roman-de-santos/E155Project/Quarto/team.qmd

---
title: "Team"
format: html
css-styles: |
  .team-member {
    text-align: center;
  }
  .team-member img {
    border-radius: 50%;
    width: 150px;
    height: 150px;
    object-fit: cover;
    margin-bottom: 1rem;
  }
  /* Button Styling */
  .linkedin-btn {
    display: inline-block;
    background-color: #0077b5; /* LinkedIn Blue */
    color: white;
    padding: 8px 16px;
    text-decoration: none;
    border-radius: 4px;
    font-size: 0.9em;
    margin-top: 10px;
    transition: background-color 0.3s;
  }
  .linkedin-btn:hover {
    background-color: #005582; /* Darker blue on hover */
    color: white;
  }
---

## Meet the Team

::: {layout-ncol=3}

::: {.team-member}


**Cameron Hernandez**

My name is Cameron Hernandez, I am a Senior at Harvey Mudd College currently perusing a bachelors in engineering. I am is passionate about electronic hardware and circuit designs. I have expierence ranging from working with power electronincs, desigining autonomous robotics, simulating electrically small antennas, and creating a multicycle processor. Stepping away from electrical engineering, I have taken engineering courses in the chemical, mechanical, material, and systems domains.

<a href="https://www.linkedin.com/in/cameron-hernandez-91b431212/" class="linkedin-btn" target="_blank">Connect on LinkedIn</a>
:::

::: {.team-member}
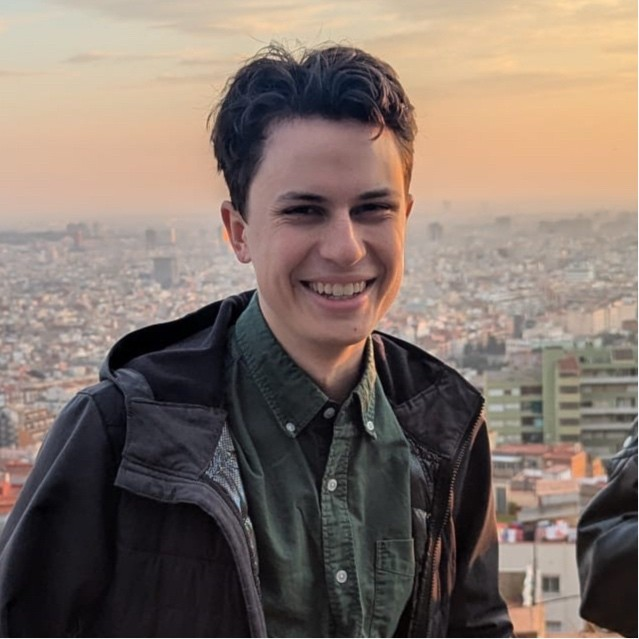
[picture p12: Quarto/images/Lucas.png]


**Lucas Lemos**

Lucas Lemos is a senior undergraduate at Harvey Mudd College studying for a B.S. Engineering. He is a self-motivated engineer & student leader passionate about merging creative design and technical expertise. He has proficiency and interest in controls and electronics. Lucas has designed an embedded audio system and PCB for Motiv Electric Trucks, an analog instrumentation PCB for the HRL Labs Clinic Team, a QTP test rack for qualifying the reactor control system PCBAs for Radiant Nuclear, and is currently developing power electronics for the Exolambda Clinic team.

<a href="https://www.linkedin.com/in/lucas-a-lemos/" class="linkedin-btn" target="_blank">Connect on LinkedIn</a>
:::

::: {.team-member}
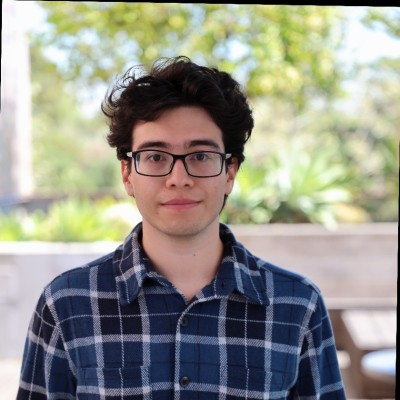
[picture p13: Quarto/images/Roman.png]


Hello, I’m Roman a student who is passionate about low-level systems. This includes C, Assembly, and IC/circuit design. I have been a TA for Computer Science, Physics, and Intro IC Lab. I am comfortable with many common Engineering software programs (Solidworks, ComSol, and Fusion) and computer languages (Matlab, Python, Java, Java Script, HTML, and C). So far, my favorite project I’ve worked on is my 32-bit CPU verification project.

**Roman De Santos**

<a href="https://www.linkedin.com/in/roman-de-santos/" class="linkedin-btn" target="_blank">Connect on LinkedIn</a>
:::

:::
