roman-de-santos/E155Project/FPGA/DSP/sim/screenshots/CDC_FTS_single.png

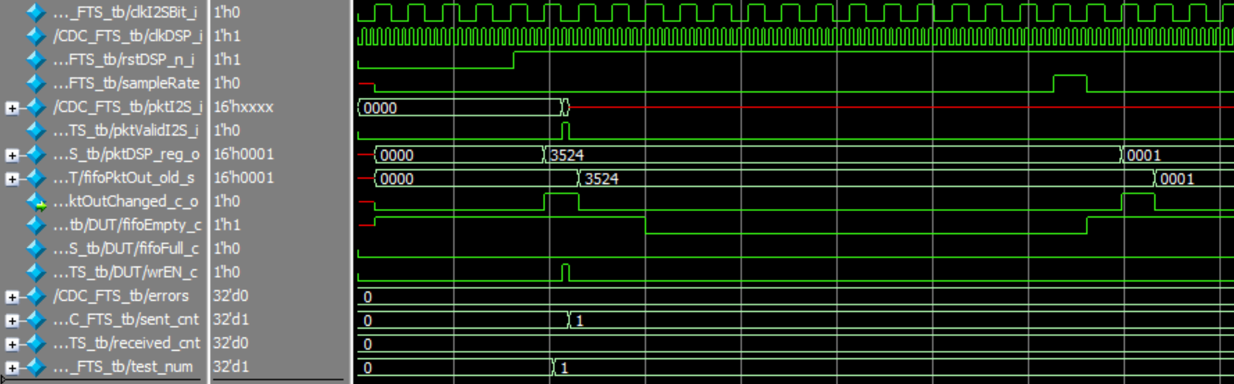
FPGA/DSP/sim/screenshots/CDC_FTS_single.png
