roman-de-santos/E155Project/FPGA/DSP/sim/screenshots/CDC_STF_multi.png

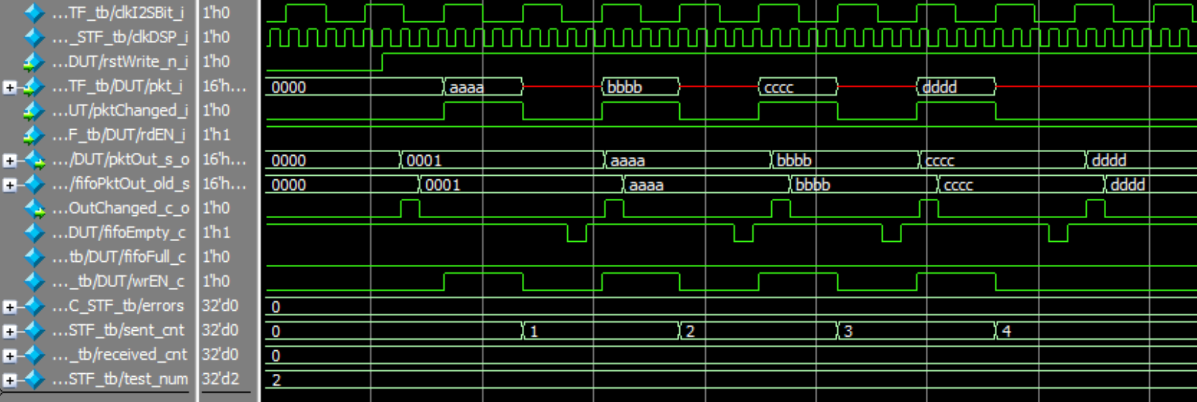
FPGA/DSP/sim/screenshots/CDC_STF_multi.png
