roman-de-santos/E155Project/FPGA/DSP/sim/screenshots/CDC_STF_single.png

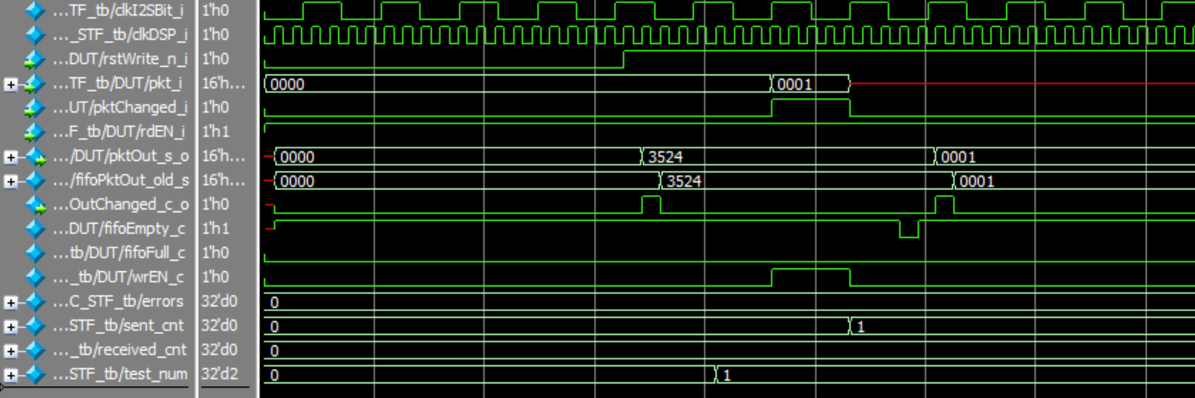
FPGA/DSP/sim/screenshots/CDC_STF_single.png
