roman-de-santos/E155Project/Gantt Chart.png

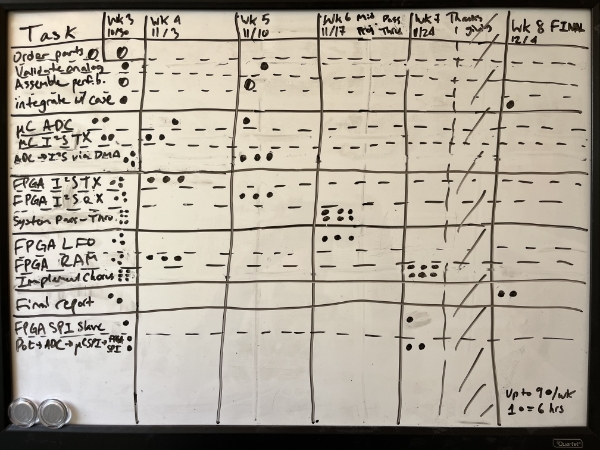
Gantt Chart.png
