roman-de-santos/E155Project/FPGA/TOP/Testbenches/screenshots/top_packet10delay10.png

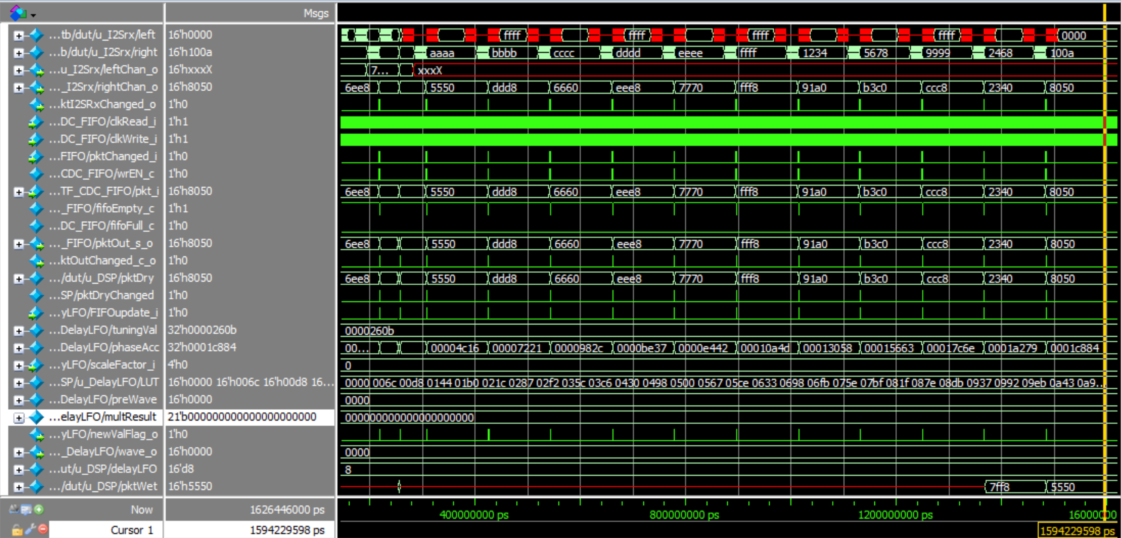
FPGA/TOP/Testbenches/screenshots/top_packet10delay10.png
