roman-de-santos/E155Project/kiCAD/tremolo_guitar_pedal/schematic3.pdf

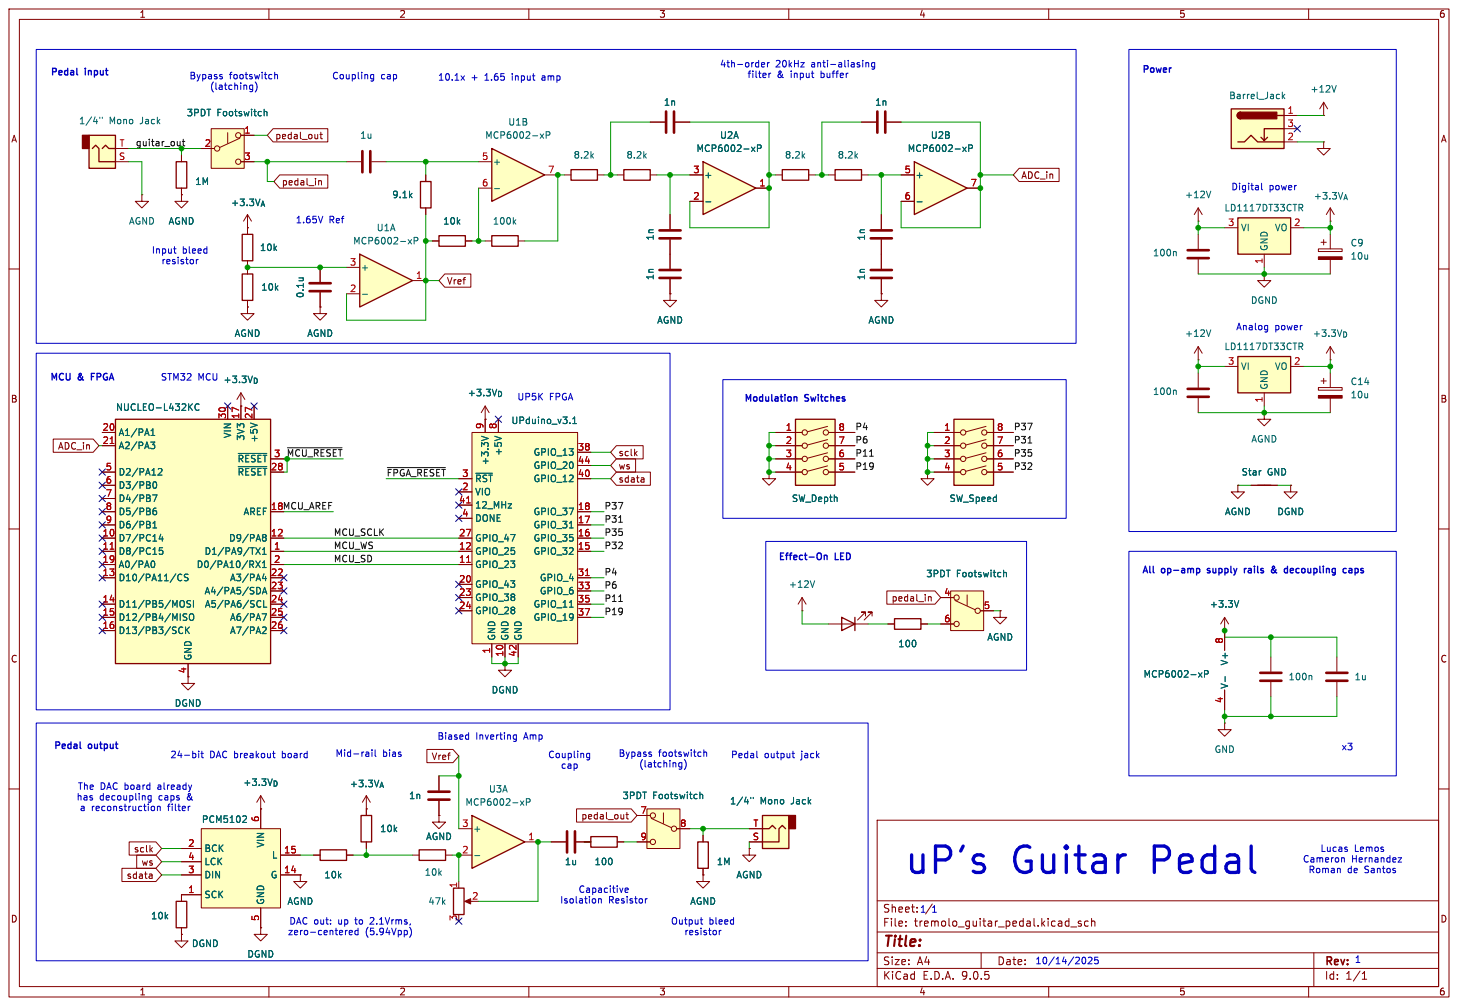
[picture p21: page 1]

14 PCM5102
Id: 1/1 Title: File: tremolo_guitar_pedal.kicad_sch Sheet: / BCK 2

Lucas Lemos Cameron Hernandez Roman de Santos
