roman-de-santos/E155Project/kiCAD/tremolo_guitar_pedal/schematic2.pdf

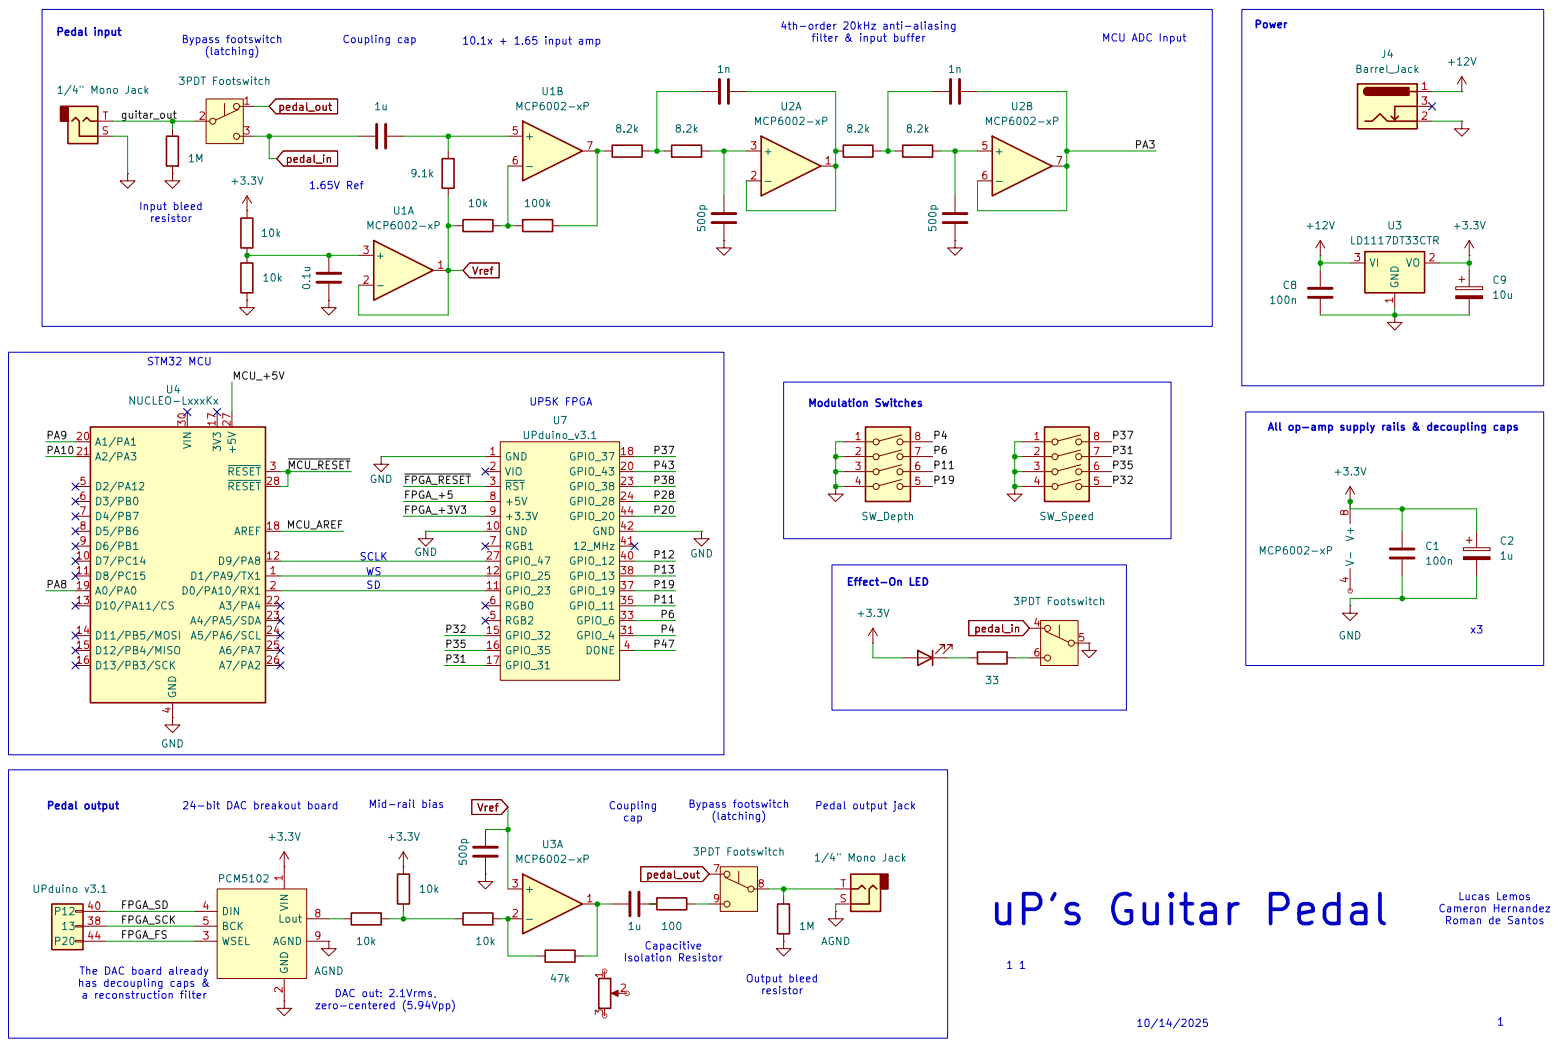
[picture p22: page 1]
