roman-de-santos/E155Project/kiCAD/tremolo_guitar_pedal/schematic1.pdf

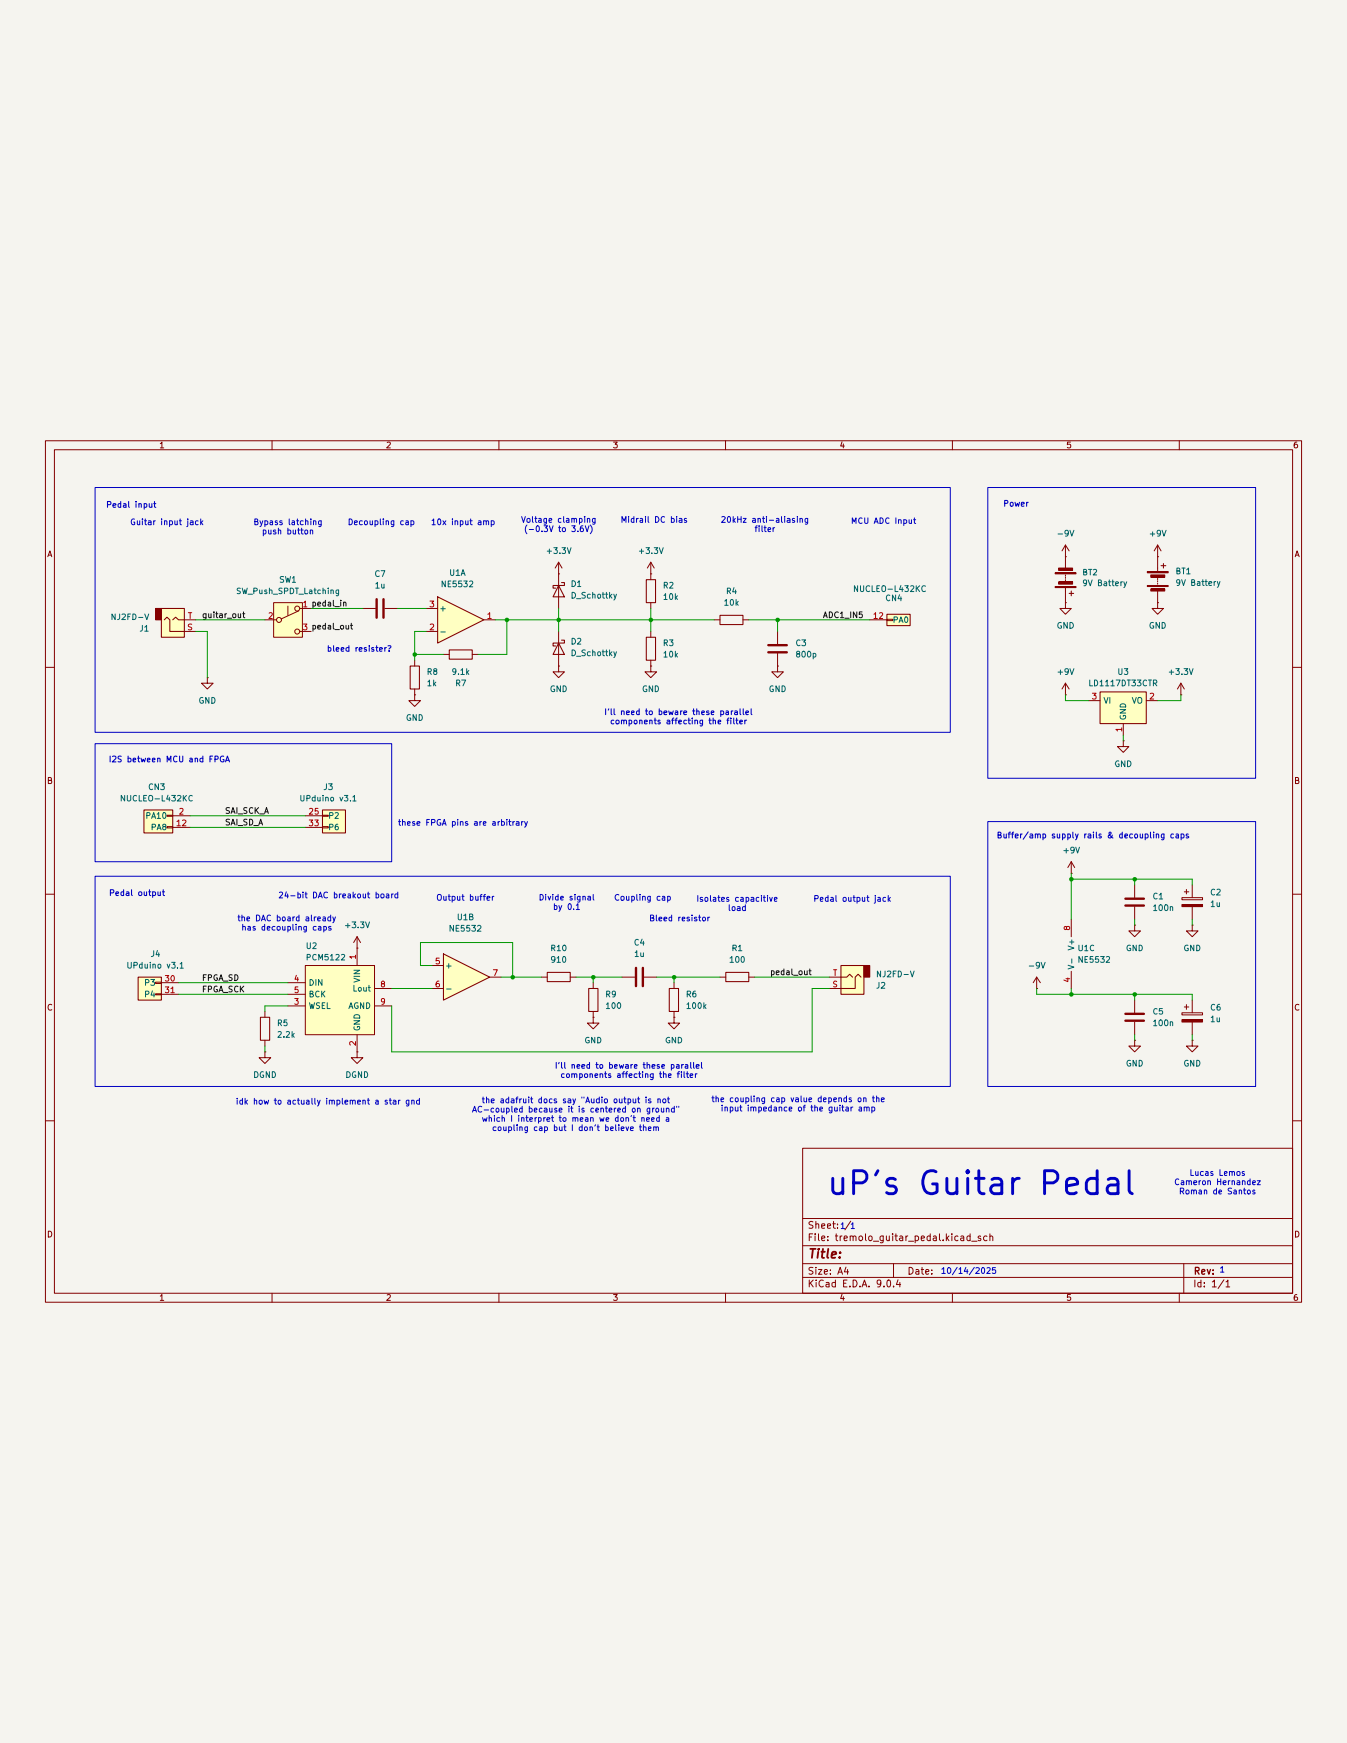
[picture p23: page 1]
