roman-de-santos/E155Project/LTspice/analog_rx.asc

C1: cap; 1n
C2: cap; 500p
C3: cap; 1n
C4: cap; 500p
C5: cap; 1µ
C6: cap; 0.1µ
C_ADC: cap; 7p
R1: res; 8.2k
R2: res; 8.2k
R3: res; 9.1k
R4: res; 10k
R5: res; 100k
R6: res; 10k
R7: res; 8.2k
R8: res; 10k
R9: res; 8.2k
R10: res; 10k
R11: res; 1Meg
R_ADC: res; 600
U1: AD8541
U2: AD8541
U7: AD8541
U8: AD8541
V1: voltage; 3.3V
V2: voltage; 9V
V6: voltage; SINE(0 300mV 80); AC 1
Named nets: 0, ADC_in, AA_out, 3V3, 9V0, AA_out2, gain_out, guitar_in, Vbias, non-inv
sallen-key 4th oorder LP AA filter
ADC sampler
.ac dec 10000 1 100k
.tran 0 100m 0 1m
simulated pickup
Biased Non-Inverting 10x Amp
w/ coupling cap
