roman-de-santos/E155Project/LTspice/analog_tx.asc

C1: cap; 0.1µ
C5: cap; 1µ
R1: res; 10k
R2: res; 10k
R3: res; 100
R4: res; 1Meg
R7: res; 10k
R8: res; 1k
U3: AD8541
V1: voltage; 3.3V
V2: voltage; 9V
V3: voltage; 1.65V
V4: voltage; SINE(0 1V 5k); AC 1
Named nets: 0, 9V0, 3V3, gain_out, dac_out, bias, coupled, out, inv, Vref
.ac dec 10000 1 100k
.tran 0 10m 0 1m
0.1x attenuation
Ref from RX chain
