roman-de-santos/E155Project/LTspice/bias_amp_rx.asc

C1: cap; 1µ
R1: res; 9.1k
R2: res; 10k
R3: res; 100k
R4: res; 10k
R5: res; 10k
R6: res; 10k
U1: AD8541
U2: AD8541
V2: voltage; 3.3
V3: voltage; SINE(0 300mV 5k); AC 1
Named nets: gain_out, 3V3, 0, guitar_in, Vbias, non-inv
.tran 0 10m 0 1m
.ac dec 10000 1 100k
