roman-de-santos/E155Project/kiCAD/tremolo_guitar_pedal/tremolo_guitar_pedal.kicad_sch

## KiCad design kiCAD/tremolo_guitar_pedal/tremolo_guitar_pedal.kicad_sch (2025-12-11, an earlier design)

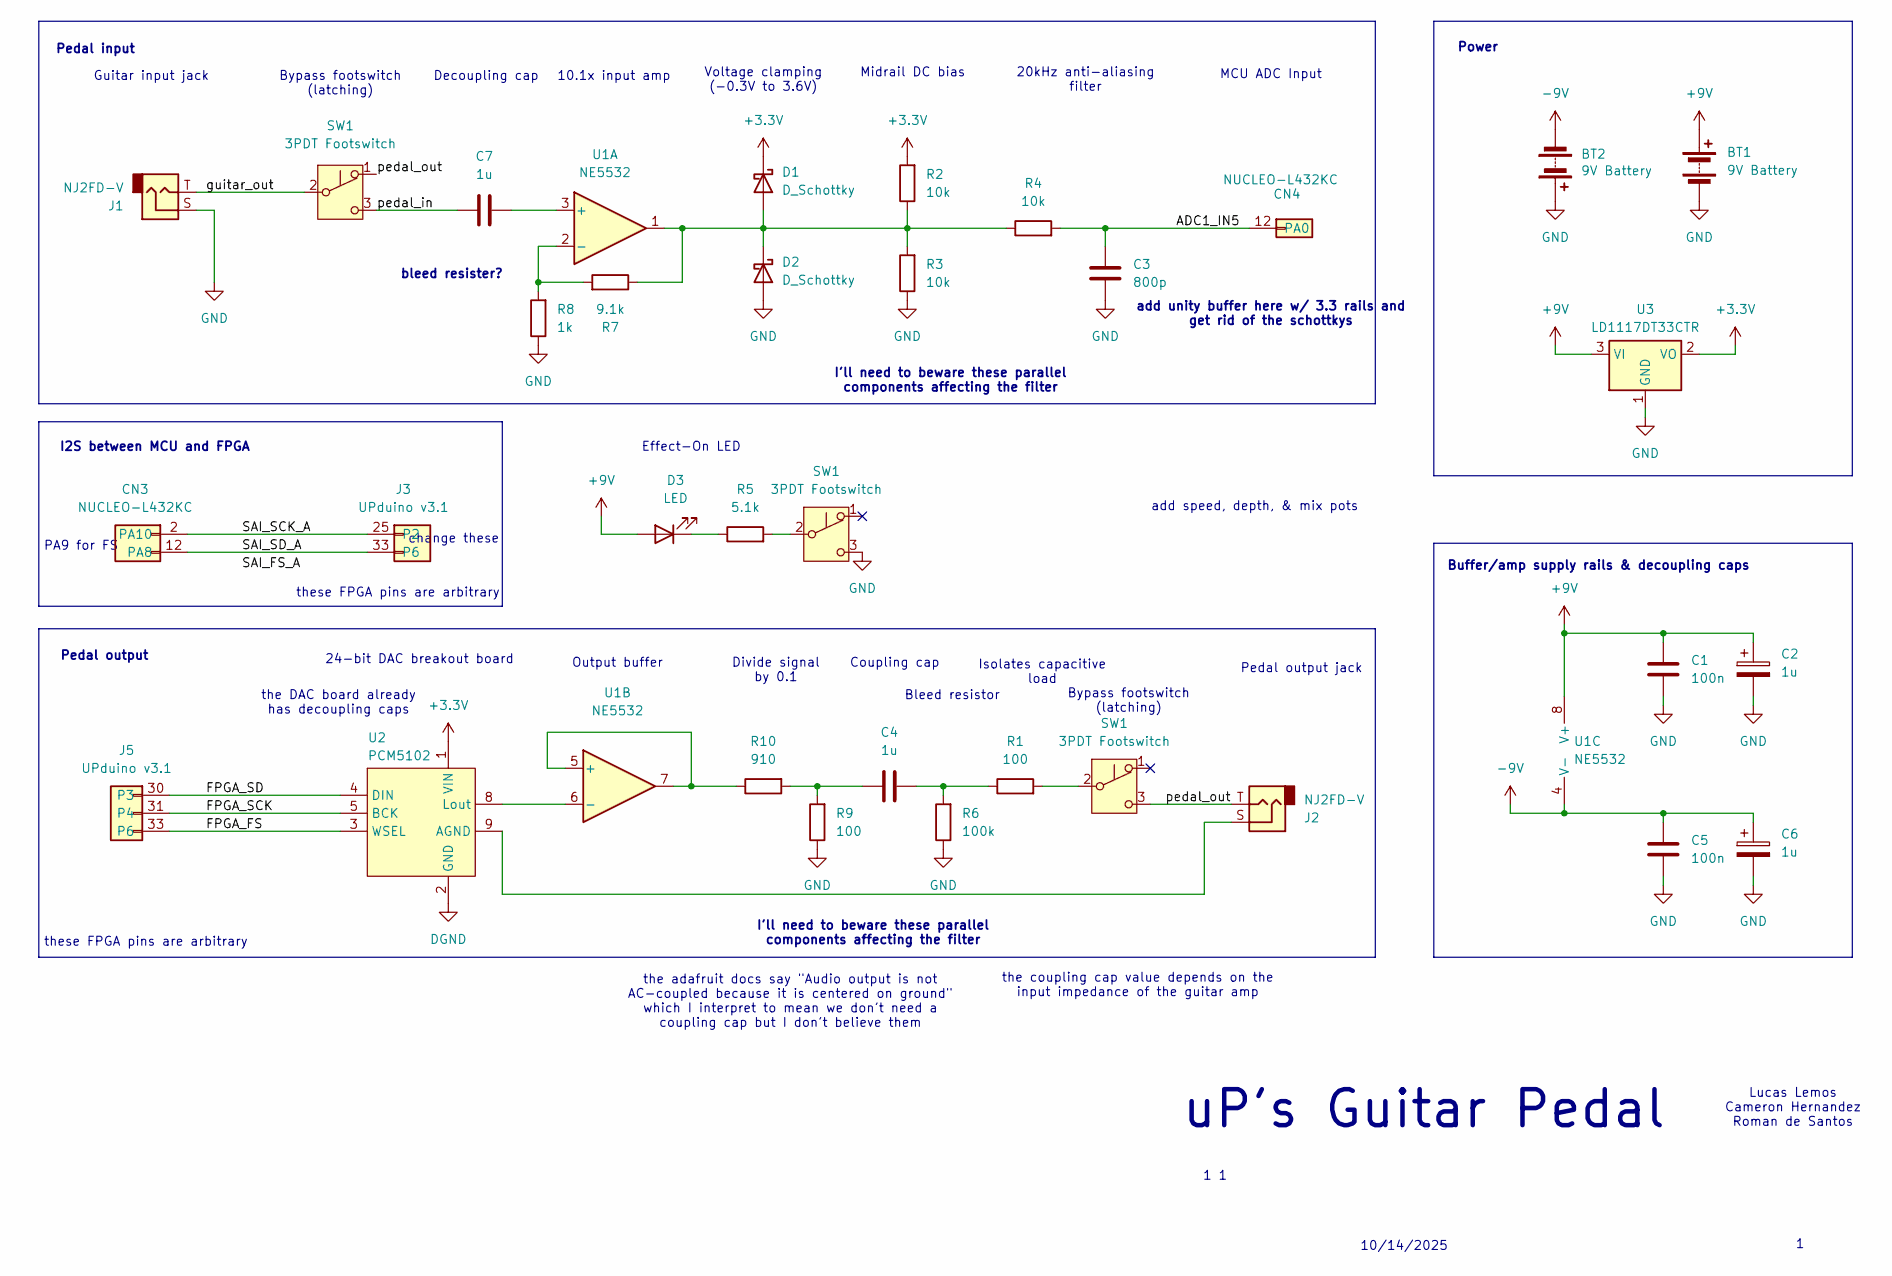
[picture p24: schematic tremolo_guitar_pedal.kicad_sch]

Parts:
BT1, BT2: 9V Battery
C1, C5: 100n
C2, C4, C6, C7: 1u
C3: 800p
CN3, CN4: NUCLEO-L432KC
D1, D2: D_Schottky
D3: LED
J1, J2: NJ2FD-V; Jack_6.35mm_Neutrik_NJ2FD-V_Vertical
J3, J5: UPduino v3.1
R1, R9: 100
R2, R3, R4: 10k
R5: 5.1k
R6: 100k
R7: 9.1k
R8: 1k
R10: 910
SW1: 3PDT Footswitch
U1: NE5532
U2: PCM5102; TSSOP-28_4.4x9.7mm_P0.65mm
U3: LD1117DT33CTR; TO-220-3_Vertical

Connections:
+3.3V: D1.1 (K), R2.2, U2.1 (VIN), U3.2 (VO)
+9V: BT1.1 (+), C1.1, C2.1, D3.2 (A), U1.8 (V+), U3.3 (VI)
-9V: BT2.2 (-), C5.1, C6.1, U1.4 (V-)
ADC1_IN5: C3.1, CN4.12, R4.2
DGND: U2.2 (GND)
FPGA_FS: J5.33 (P6), U2.3 (WSEL)
FPGA_SCK: J5.31 (P4), U2.5 (BCK)
FPGA_SD: J5.30 (P3), U2.4 (DIN)
GND: BT1.2 (-), BT2.1 (+), C1.2, C2.2, C3.2, C5.2, C6.2, D2.2 (A), J1.S, R3.1, R6.1, R8.1, R9.1, SW1.3 (C), U3.1 (GND)
unnamed: C4.1, R9.2, R10.2
unnamed: C4.2, R1.1, R6.2
unnamed: C7.2, U1.3 (+)
unnamed: D1.2 (A), D2.1 (K), R2.1, R3.2, R4.1, R7.1, U1.1
unnamed: D3.1 (K), R5.1
unnamed: J2.S, U2.9 (AGND)
unnamed: R1.2, SW1.2 (B)
unnamed: R5.2, SW1.2 (B)
unnamed: R7.2, R8.2, U1.2 (-)
unnamed: R10.1, U1.5 (+), U1.7
unnamed: U1.6 (-), U2.8 (Lout)
SAI_SCK_A: CN3.2 (PA10), J3.25 (P2)
SAI_SD_A: CN3.12 (PA8), J3.33 (P6)
guitar_out: J1.T, SW1.2 (B)
pedal_in: C7.1, SW1.3 (C)
pedal_out: J2.T, SW1.1 (A), SW1.3 (C)

Notes on the sheet:
10/14/2025
uP's Guitar Pedal
Buffer/amp supply rails & decoupling caps
Pedal output jack
PA9 for FS
the adafruit docs say "Audio output is not AC-coupled because it is centered on ground" which I interpret to mean we don't need a coupling cap but I don't believe them
Lucas Lemos Cameron Hernandez Roman de Santos
10.1x input amp
20kHz anti-aliasing filter
add speed, depth, & mix pots
Bypass footswitch (latching)
Output buffer
these FPGA pins are arbitrary
Power
Isolates capacitive load
the DAC board already has decoupling caps
change these
I'll need to beware these parallel components affecting the filter
24-bit DAC breakout board
Midrail DC bias
bleed resister?
1 1
Voltage clamping (-0.3V to 3.6V)
Guitar input jack
Coupling cap
the coupling cap value depends on the input impedance of the guitar amp
Bleed resistor
Pedal input
add unity buffer here w/ 3.3 rails and get rid of the schottkys
MCU ADC Input
Decoupling cap
I2S between MCU and FPGA
Effect-On LED
Divide signal by 0.1
Pedal output
