roman-de-santos/E155Project/MCU/STMcubeMX/Core/Src/main.c

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
/* Includes ------------------------------------------------------------------*/
#include "main.h"
#include "adc.h"
#include "dma.h"
#include "sai.h"
#include "tim.h"
#include "usart.h"
#include "gpio.h"

/* USER CODE BEGIN PD */
#define BUFFER_SIZE 2048 // Size of the audio buffer (samples). Must be even.
/* USER CODE END PD */


/* USER CODE BEGIN PV */
// Buffer to store data coming IN from the ADC
volatile uint16_t adc_buffer[BUFFER_SIZE];

// Buffer to send data OUT to the SAI
volatile uint16_t sai_buffer[BUFFER_SIZE];
/* USER CODE END PV */

void SystemClock_Config(void);
void PeriphCommonClock_Config(void);
/**
  * @brief  The application entry point.
  * @retval int
  */
int main(void)
{

  /* MCU Configuration--------------------------------------------------------*/

  /* Reset of all peripherals, Initializes the Flash interface and the Systick. */
  HAL_Init();

  /* Configure the system clock */
  SystemClock_Config();

  /* Configure the peripherals common clocks */
  PeriphCommonClock_Config();

  /* Initialize all configured peripherals */
  MX_GPIO_Init();
  MX_DMA_Init();
  MX_ADC1_Init();
  MX_USART2_UART_Init();
  MX_SAI1_Init();
  MX_TIM1_Init();
  /* USER CODE BEGIN 2 */

  // Run ADC Calibration
  if (HAL_ADCEx_Calibration_Start(&hadc1, ADC_SINGLE_ENDED) != HAL_OK)
  {
    Error_Handler();
  }

  // 1. Start the SAI (Output) first so it is ready to receive data
  // Note: We cast to uint8_t* because the HAL function expects it, even for 16-bit data.
  // If audio sounds weird/fast, try multiplying size by 2: (BUFFER_SIZE * 2)
  if (HAL_SAI_Transmit_DMA(&hsai_BlockA1, (uint8_t*)sai_buffer, BUFFER_SIZE) != HAL_OK)
  {
    Error_Handler();
  }

  // 2. Start the ADC (Input) in DMA mode
  // It will prepare the DMA but wait for the Timer trigger to actually start sampling
  if (HAL_ADC_Start_DMA(&hadc1, (uint32_t*)adc_buffer, BUFFER_SIZE) != HAL_OK)
  {
    Error_Handler();
  }

  // 3. Start the Timer (The Metronome)
  // This starts the 44.1kHz pulses. ADC grabs a sample on every pulse.
  if (HAL_TIM_Base_Start(&htim1) != HAL_OK)
  {
    Error_Handler();
  }

  /* USER CODE END 2 */

  /* Infinite loop */
  /* USER CODE BEGIN WHILE */
  while (1)
  {
    /* USER CODE END WHILE */

    /* USER CODE BEGIN 3 */
  }
  /* USER CODE END 3 */
}

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
/* USER CODE BEGIN 4 */

// Callback: Half of the ADC buffer is full
void HAL_ADC_ConvHalfCpltCallback(ADC_HandleTypeDef* hadc)
{
    // While the ADC is filling the SECOND half, we copy the FIRST half to SAI
    if (hadc->Instance == ADC1)
    {
        for (int i = 0; i < BUFFER_SIZE / 2; i++)
        {
            sai_buffer[i] = adc_buffer[i];
        }
    }
}

// Callback: The entire ADC buffer is full
void HAL_ADC_ConvCpltCallback(ADC_HandleTypeDef* hadc)
{
    // While the ADC wraps around to fill the FIRST half, we copy the SECOND half to SAI
    if (hadc->Instance == ADC1)
    {
        for (int i = BUFFER_SIZE / 2; i < BUFFER_SIZE; i++)
        {
            sai_buffer[i] = adc_buffer[i];
        }
    }
}

/* USER CODE END 4 */
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
