roman-de-santos/E155Project/MCU/STMcubeMX/STMcubeMX.ioc

Mcu.UserName=STM32L432KCUx
PA0.GPIO_Label=MCO [High speed clock in]
PA0.Signal=RCC_CK_IN
PA10.Signal=SAI1_SD_A
PA2.GPIO_Label=VCP_TX
PA2.Signal=USART2_TX
PA3.Signal=ADCx_IN8
PA8.Signal=SAI1_SCK_A
PA9.Signal=SAI1_FS_A
