roman-de-santos/E155Project/FPGA/DSP/src/AsyncFIFO/eval/dut_inst.v

    AsyncFIFO u_AsyncFIFO(.wr_clk_i(wr_clk_i),
        .rd_clk_i(rd_clk_i),
        .rst_i(rst_i),
        .rp_rst_i(rp_rst_i),
        .wr_en_i(wr_en_i),
        .rd_en_i(rd_en_i),
        .wr_data_i(wr_data_i),
        .full_o(full_o),
        .empty_o(empty_o),
        .rd_data_o(rd_data_o));
