roman-de-santos/E155Project/(commit log)

2025-11-06 Added kiCAD schematic
    From my personal files. It's mostly done but slightly unfinished
    [tremolo_guitar_pedal.kicad_pcb, tremolo_guitar_pedal.kicad_sch]
2025-11-12 first pass at circular buffer
    and a few kiCAD edits
    [tremolo_guitar_pedal.kicad_sch]
2025-11-19 Switched to STMIDE for HAL Compatibility
2025-11-19 Updated and Tested Code (Working perhaps)
    [STMcubeMX Debug.cfg]
2025-11-22 Analog passthrough works
    Assuming an input from the guitar of up to ~280mVpp. I may need to reduce the amplification once I start testing w/ the actual guitar.
    [tremolo_guitar_pedal.kicad_sch]
2025-11-26 Async FIFO module + testbench isn't working
    The write side is working (writes four packets then full flag goes high) but the read side is not because the empty flag never goes low.
    Debug steps:
    * Switching polarity on reset did nothing
    * Tying read enable always high did nothing
    * Found logic inside the FIFO IP module which suggests that it's properly writing four times and successfully reads from the EBR *once*
    Gemini thinks that something is causing the read pointer to not synchronize from writePtr -> grayPtr -> readPtr, which is causing the empty flag to stay high and therefore the data read from the EBR is never being output. It suspects there may be something wrong with the reset.
    [AsyncFIFO.cfg]
2025-12-01 Both FIFO directions working
    Implemented FTS by swapping the CDC clock inputs in the test bench
    [CDC_FIFO.sv, CDC_FTS_tb.sv]
2025-12-02 CDC Fully Working
    Disabled first word fall through. A single "CDC" module works for both STF and FTS.
    Known bugs:
    * If you write more packets than the depth of the buffer, the full flag latches always high
    * The async FIFO outputs a garbage value after reset and therefore sends a pktChanged flag for that garbage packet
    [AsyncFIFO.cfg]
2025-12-02 Moved DSP to new radiant project
    And a few DSP module syntax error patches
    [AsyncFIFO.cfg]
2025-12-02 Update top_tb connectors
2025-12-02 more tweaks from simming
    Changed i2srx to <<3 and output flag on the right sample. Also updated testbench
2025-12-04 FPGA I2S Pin Updates
2025-12-04 Some tweaks for simmability
    Also updated the .gitignore
    [tremolo_guitar_pedal.kicad_sch]
2025-12-04 Removed popping noise from LFO
    [LFOgen.sv, LFOgen_tb.sv]
2025-12-05 Schematic update
    [tremolo_guitar_pedal.kicad_sch]
2025-12-05 Website Initial
    [tremolo_guitar_pedal.kicad_sch]
2025-12-06 Digital I2S trace
2025-12-11 Fixed schematic ports
    for MCU & FPGA
    [tremolo_guitar_pedal.kicad_sch]
